marius1/ledcube/schema/ledcube.brd

## EAGLE design schema/ledcube.brd (2014-06-30)

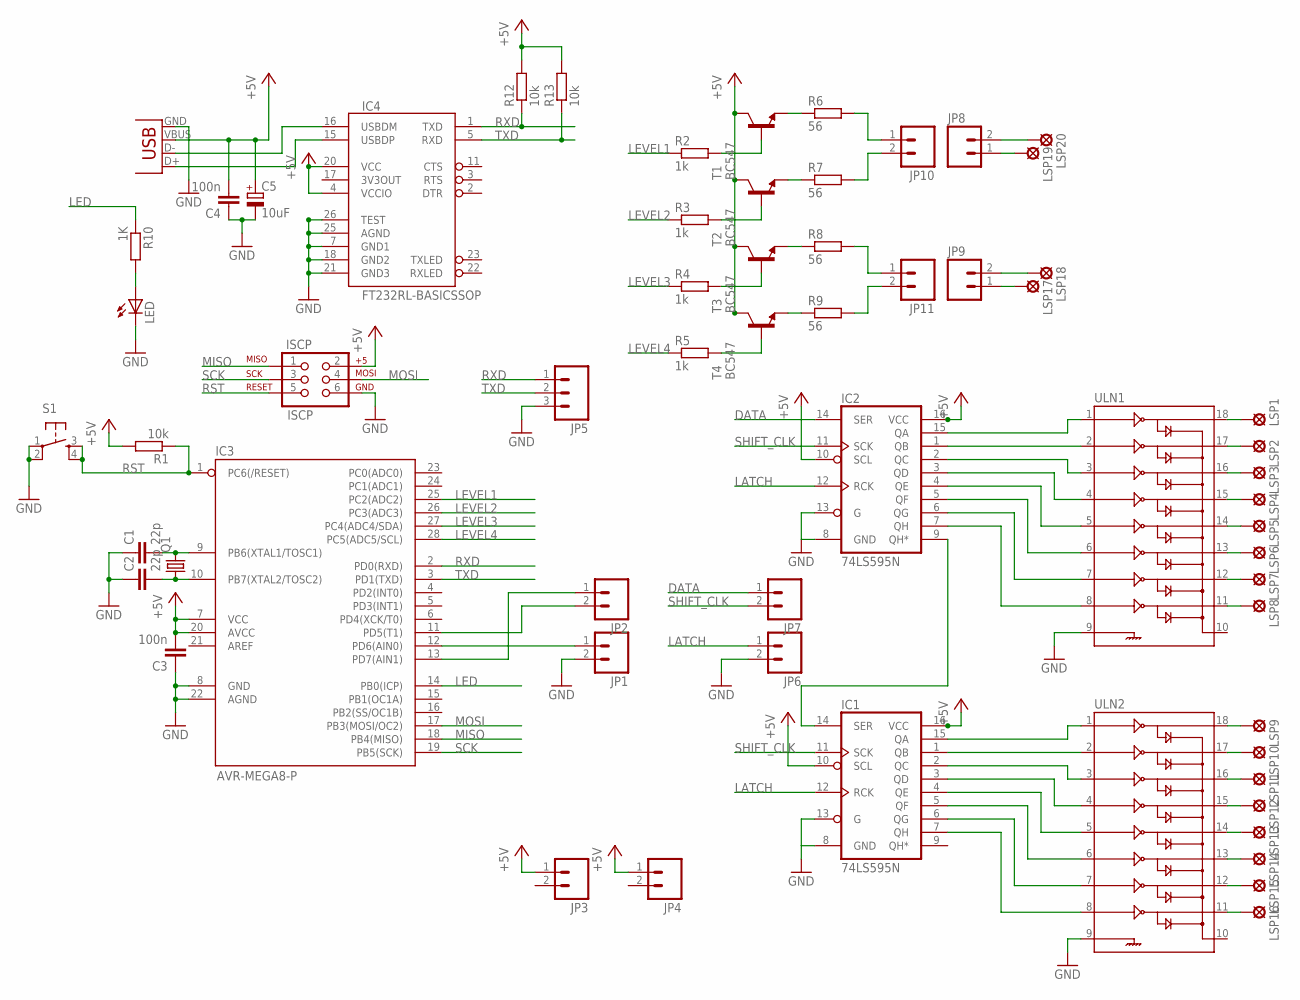
[picture p1: schematic ledcube.sch]

Parts:
C1, C2: 22p; C050-024X044
C3, C4: 100n; C050-024X044
C5: 10uF; E2,5-6
IC1, IC2: 74LS595N; DIL16
IC3: AVR-MEGA8-P; DIL28-3
IC4: FT232RL-BASICSSOP; SSOP28DB
ISCP: ISCP; 2X3-NS
JP1, JP2, JP3, JP4, JP6, JP7, JP8, JP9, JP10, JP11: M02PTH3; 1X02_LONGPADS
JP5: M03PTH; 1X03
LED: LED3MM
LSP1, LSP2, LSP3, LSP4, LSP5, LSP6, LSP7, LSP8, LSP9, LSP10, LSP11, LSP12, LSP13, LSP14, LSP15, LSP16, LSP17, LSP18, LSP19, LSP20: LSP10
Q1: CRYSTALHC49S; HC49/S
R1, R12, R13: 10k; 0204V
R2, R3, R4, R5: 1k; 0204V
R6, R7, R8, R9: 56; 0204V
R10: 1K; 0204V
S1: TAC_SWITCHPTH; TACTILE-PTH
T1, T2, T3, T4: BC547; TO92
ULN1, ULN2: ULN2803DIP; DIL18
X1: USBSMD; USB-MINIB

Connections:
+5V: C3.2, C4.2, C5.+, IC1.10 (SCL), IC1.16 (VCC), IC2.10 (SCL), IC2.16 (VCC), IC3.7 (VCC), IC3.20 (AVCC), IC4.4 (VCCIO), IC4.20 (VCC), ISCP.2, JP3.1, JP4.1, R1.2, R12.2, R13.2, T1.3 (C), T2.3 (C), T3.3 (C), T4.3 (C), X1.VBUS
DATA: IC2.14 (SER), JP7.1
GND: C1.1, C2.1, C3.1, C4.1, C5.-, IC1.8 (GND), IC1.13 (G), IC2.8 (GND), IC2.13 (G), IC3.8 (GND), IC3.22 (AGND), IC4.7 (GND1), IC4.18 (GND2), IC4.21 (GND3), IC4.25 (AGND), IC4.26 (TEST), ISCP.6, JP1.2, JP5.3, JP6.2, LED.K (C), S1.1, S1.2, ULN1.9, ULN2.9, X1.GND
LATCH: IC1.12 (RCK), IC2.12 (RCK), JP6.1
LED: IC3.14 (PB0(ICP)), R10.1
LEVEL1: IC3.25 (PC2(ADC2)), R2.1
LEVEL2: IC3.26 (PC3(ADC3)), R3.1
LEVEL3: IC3.27 (PC4(ADC4/SDA)), R4.1
LEVEL4: IC3.28 (PC5(ADC5/SCL)), R5.1
MISO: IC3.18 (PB4(MISO)), ISCP.1
MOSI: IC3.17 (PB3(MOSI/OC2)), ISCP.4
unnamed: R6.1, T1.1 (E)
unnamed: R7.1, T2.1 (E)
unnamed: R8.1, T3.1 (E)
unnamed: R9.1, T4.1 (E)
unnamed: R5.2, T4.2 (B)
unnamed: R4.2, T3.2 (B)
unnamed: R3.2, T2.2 (B)
unnamed: R2.2, T1.2 (B)
unnamed: C2.2, IC3.10 (PB7(XTAL2/TOSC2)), Q1.1
unnamed: C1.2, IC3.9 (PB6(XTAL1/TOSC1)), Q1.2
unnamed: JP10.1, R6.2
unnamed: IC4.16 (USBDM), X1.D-
unnamed: IC4.15 (USBDP), X1.D+
unnamed: IC1.15 (QA), ULN2.1
unnamed: IC1.1 (QB), ULN2.2
unnamed: IC1.2 (QC), ULN2.3
unnamed: IC1.3 (QD), ULN2.4
unnamed: IC1.4 (QE), ULN2.5
unnamed: IC1.5 (QF), ULN2.6
unnamed: IC1.6 (QG), ULN2.7
unnamed: IC1.7 (QH), ULN2.8
unnamed: IC2.15 (QA), ULN1.1
unnamed: IC2.1 (QB), ULN1.2
unnamed: IC2.2 (QC), ULN1.3
unnamed: IC2.3 (QD), ULN1.4
unnamed: IC2.4 (QE), ULN1.5
unnamed: IC2.5 (QF), ULN1.6
unnamed: IC2.6 (QG), ULN1.7
unnamed: IC2.7 (QH), ULN1.8
unnamed: JP9.1, LSP17.MP
unnamed: JP11.1, R8.2
unnamed: JP11.2, R9.2
unnamed: IC3.11 (PD5(T1)), JP2.2
unnamed: IC3.12 (PD6(AIN0)), JP1.1
unnamed: IC3.13 (PD7(AIN1)), JP2.1
unnamed: JP10.2, R7.2
unnamed: JP9.2, LSP18.MP
unnamed: JP8.1, LSP19.MP
unnamed: JP8.2, LSP20.MP
unnamed: LSP16.MP, ULN2.11
unnamed: LSP15.MP, ULN2.12
unnamed: LSP14.MP, ULN2.13
unnamed: LSP13.MP, ULN2.14
unnamed: LSP12.MP, ULN2.15
unnamed: LSP11.MP, ULN2.16
unnamed: LSP10.MP, ULN2.17
unnamed: LSP9.MP, ULN2.18
unnamed: IC1.14 (SER), IC2.9 (QH*)
unnamed: LED.A, R10.2
unnamed: LSP8.MP, ULN1.11
unnamed: LSP1.MP, ULN1.18
unnamed: LSP7.MP, ULN1.12
unnamed: LSP6.MP, ULN1.13
unnamed: LSP5.MP, ULN1.14
unnamed: LSP4.MP, ULN1.15
unnamed: LSP3.MP, ULN1.16
unnamed: LSP2.MP, ULN1.17
RST: IC3.1 (PC6(/RESET)), ISCP.5, R1.1, S1.3, S1.4
RXD: IC3.2 (PD0(RXD)), IC4.1 (TXD), JP5.1, R12.1
SCK: IC3.19 (PB5(SCK)), ISCP.3
SHIFT_CLK: IC1.11 (SCK), IC2.11 (SCK), JP7.2
TXD: IC3.3 (PD1(TXD)), IC4.5 (RXD), JP5.2, R13.1

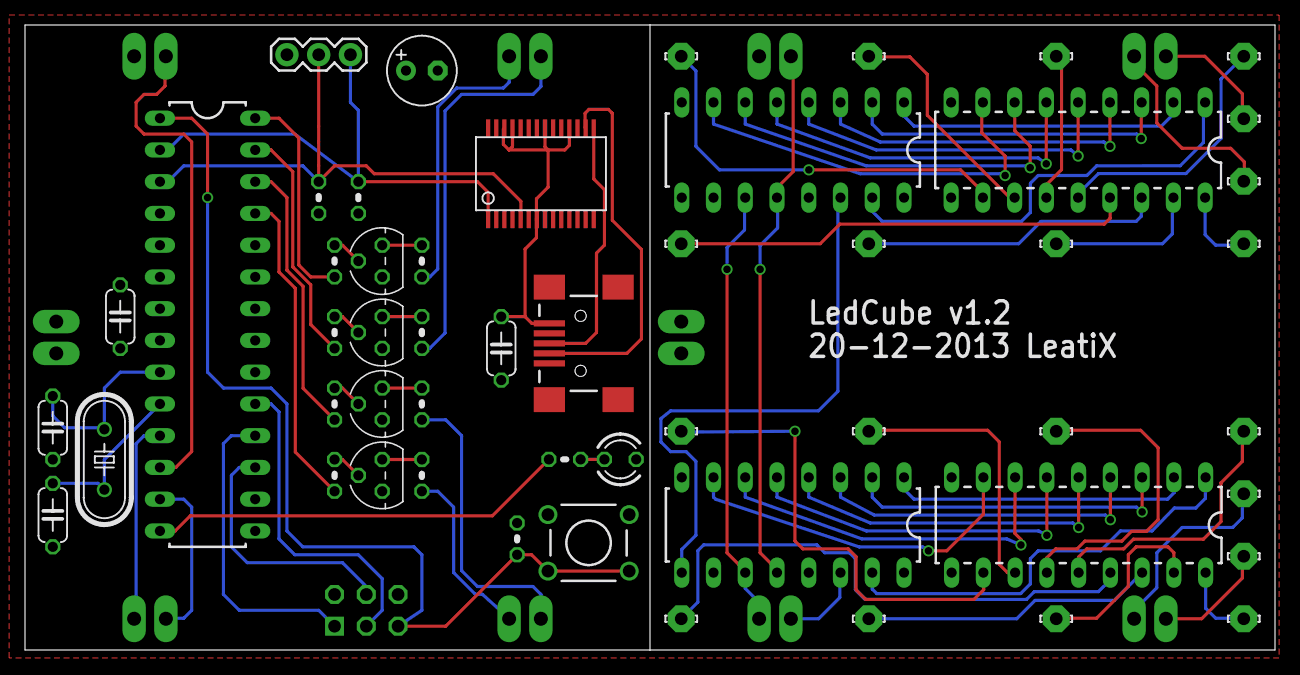
[picture p2: board ledcube.brd from above]

Board: 4 copper layers, 100.0 x 50.0 mm, 63 parts (0 on the bottom side), 73 nets.
