marius1/ledcube/(commit log)

2014-06-30 BOM added
2014-06-30 Schema bug updated
    [ledcube.brd, ledcube.sch]
